TheBitBiscuit/MegaAMP/Mk. I/MegaAMP-Installed.jpeg

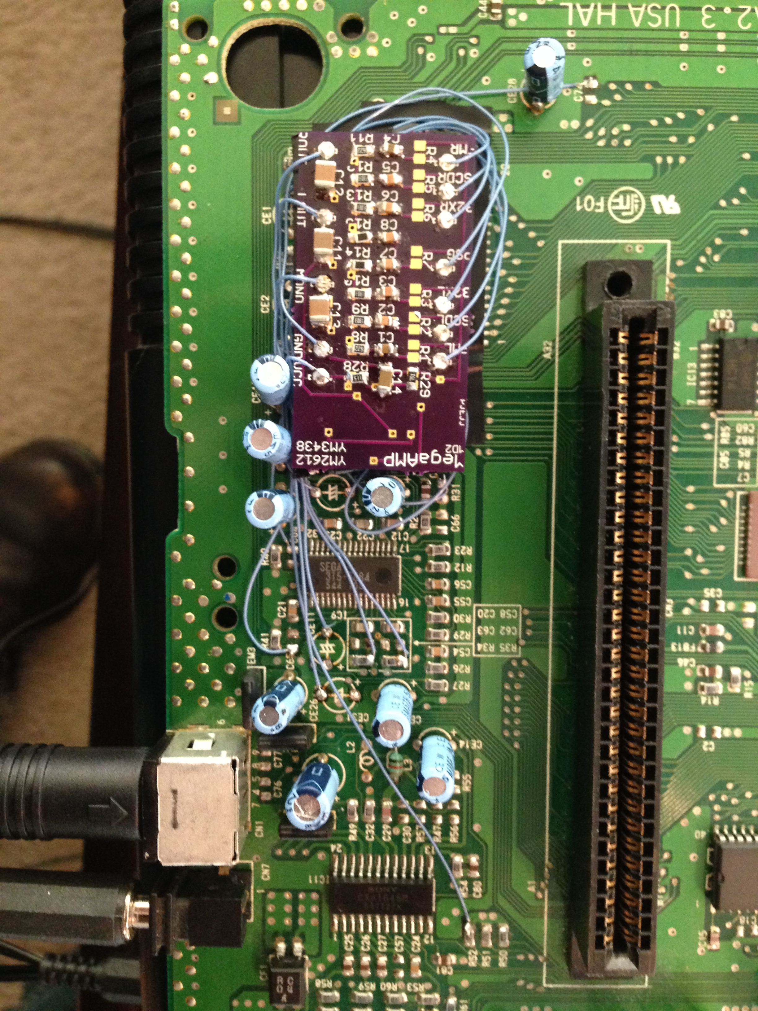
Mk. I/MegaAMP-Installed.jpeg
