TheBitBiscuit/MegaAMP/Install Diagram/MD2VA0-VA1.8-Common.jpg

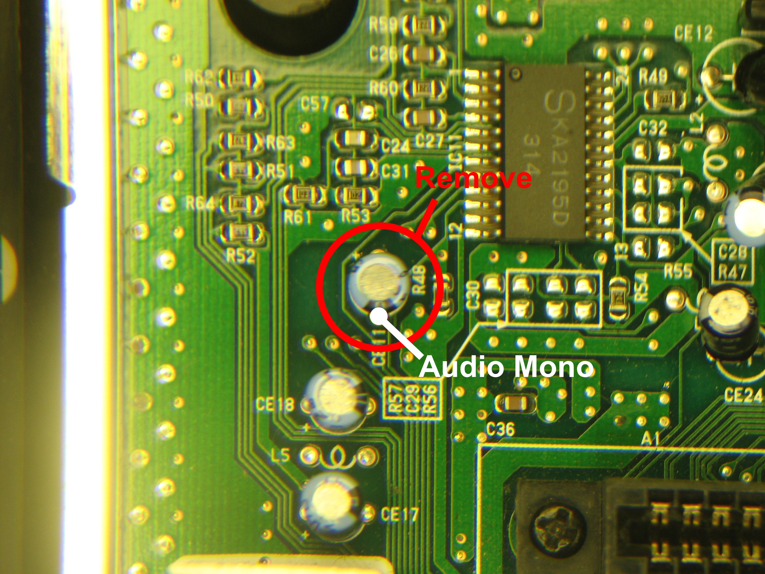
Install Diagram/MD2VA0-VA1.8-Common.jpg
