TheBitBiscuit/MegaAMP/README.md

# MegaAMP
 Audio filter and amplifier for Sega Genesis/Mega Drive.  Board and Schematics were put together with CadSoft Eagle. Mk.I was built and fabbed by OSHpark and installed in one of my own Genesis.
