TheBitBiscuit/MegaAMP/Schmatics/MegaAMP-MD2.png

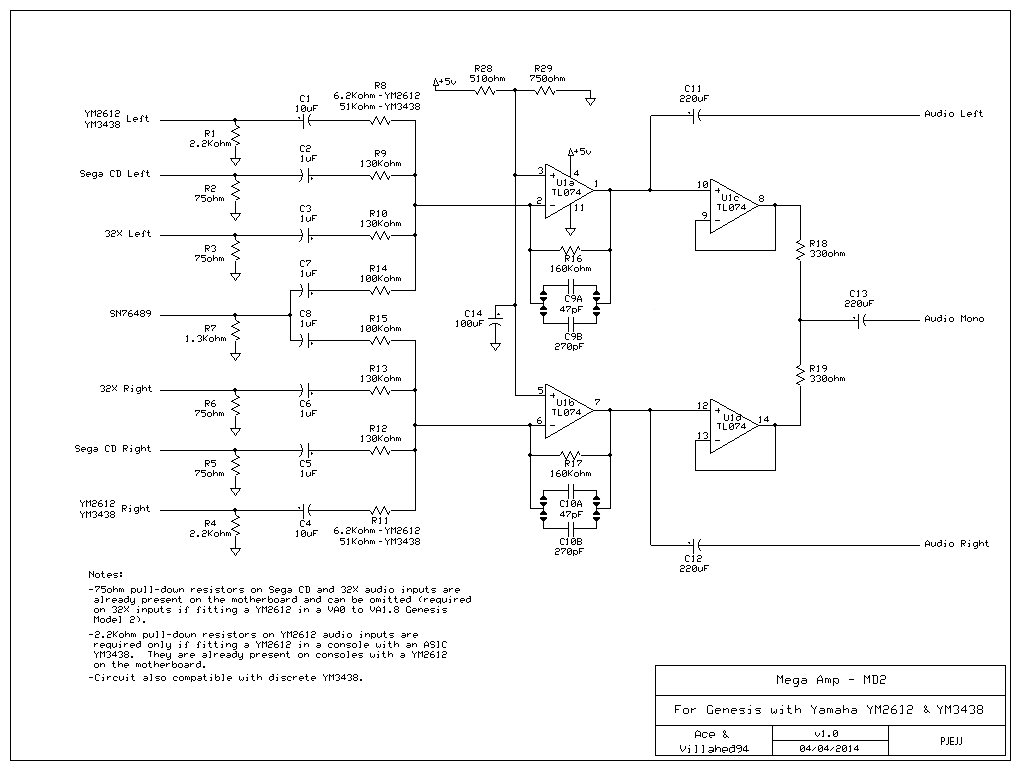
Schmatics/MegaAMP-MD2.png
