TheBitBiscuit/MegaAMP/Mk. I/MegaAMP.Mk1.Parts-List.xlsx

MegaAMP Mk. I Parts List
Name | Value | Package | Digikey Part # | Notes
R1 - Note 1 | 2.2K | 0805 | 311-2.20KCRCT-ND | Note 1
R2 - Note 2 | 75 | 0805 | 311-75.0CRCT-ND | 2.2Kohm pull-down resistors
R3 - Note 2 | 75 | 0805 | 311-75.0CRCT-ND | are only required if fitting a
R4 - Note 1 | 2.2K | 0805 | 311-2.20KCRCT-ND | YM2612 into system with
R5 - Note 2 | 75 | 0805 | 311-75.0CRCT-ND | ASIC YM3438. Already on
R6 - Note 2 | 75 | 0805 | 311-75.0CRCT-ND | the board of YM2612.
R7 | 1.3K | 0805 | 311-1.30KCRCT-ND
R8 - Note 3 | 6.2K - YM2612 | 0805 | 311-6.20KCRCT-ND | Note 2
 | 51K - YM3438 | 0805 | 311-51.0KCRCT-ND | 75ohm pull-down resistors
R9 | 130K | 0805 | 311-130KCRCT-ND | on CD & 32X audio inputs are
R10 | 130K | 0805 | 311-130KCRCT-ND | already present on the board
R11 - Note 3 | 6.2K - YM2612 | 0805 | 311-6.20KCRCT-ND | and can be omitted.
 | 51K - YM3438 | 0805 | 311-51.0KCRCT-ND | (Required on 32X inputs if
R12 | 130K | 0805 | 311-130KCRCT-ND | fitting YM2612 in a VA0 to
R13 | 130K | 0805 | 311-130KCRCT-ND | VA1.8 Model 2)
R14 | 100K | 0805 | 311-100KCRCT-ND
R15 | 100K | 0805 | 311-100KCRCT-ND | Note 3
R16 | 160K | 0805 | 311-160KCRCT-ND | This resistor's value changes
R17 | 160K | 0805 | 311-160KCRCT-ND | depending on what audio
R18 | 330 | 0805 | 311-330CRCT-ND | processor is being used.
R19 | 330 | 0805 | 311-330CRCT-ND | On a YM2612 system, use
R28 | 510 | 0805 | 311-510CRCT-ND | 6.2Kohm.
R29 | 750 | 0805 | 311-750CRCT-ND | On a YM3438 system, use
C1 | 10uF | 0805 | 1276-2891-1-ND | 51Kohm.
C2 | 1uF | 0805 | 1276-1066-1-ND
C3 | 1uF | 0805 | 1276-1066-1-ND
C4 | 10uF | 0805 | 1276-2891-1-ND
C5 | 1uF | 0805 | 1276-1066-1-ND
C6 | 1uF | 0805 | 1276-1066-1-ND
C7 | 1uF | 0805 | 1276-1066-1-ND
C8 | 1uF | 0805 | 1276-1066-1-ND
C9A | 0.47pF | 0805 | 1276-2700-1-ND
C9B | 270pF | 0805 | 1276-1262-1-ND
C10A | 0.47pF | 0805 | 1276-2700-1-ND
C10B | 270pF | 0805 | 1276-1262-1-ND
C11 | 220uF | 1210 | 1276-3375-1-ND
C12 | 220uF | 1210 | 1276-3375-1-ND
C13 | 220uF | 1210 | 1276-3375-1-ND
C14 | 100uF | 1206 | 1276-1782-1-ND
TL074CDR | OPAMP | 14SOIC | 296-1283-1-ND
 |  |  |  | PJEJJ 2014
