TheBitBiscuit/MegaAMP/Mk. I/MegaAMP.Mk1.brd

## EAGLE design Mk. I/MegaAMP.Mk1.brd (2023-05-29)

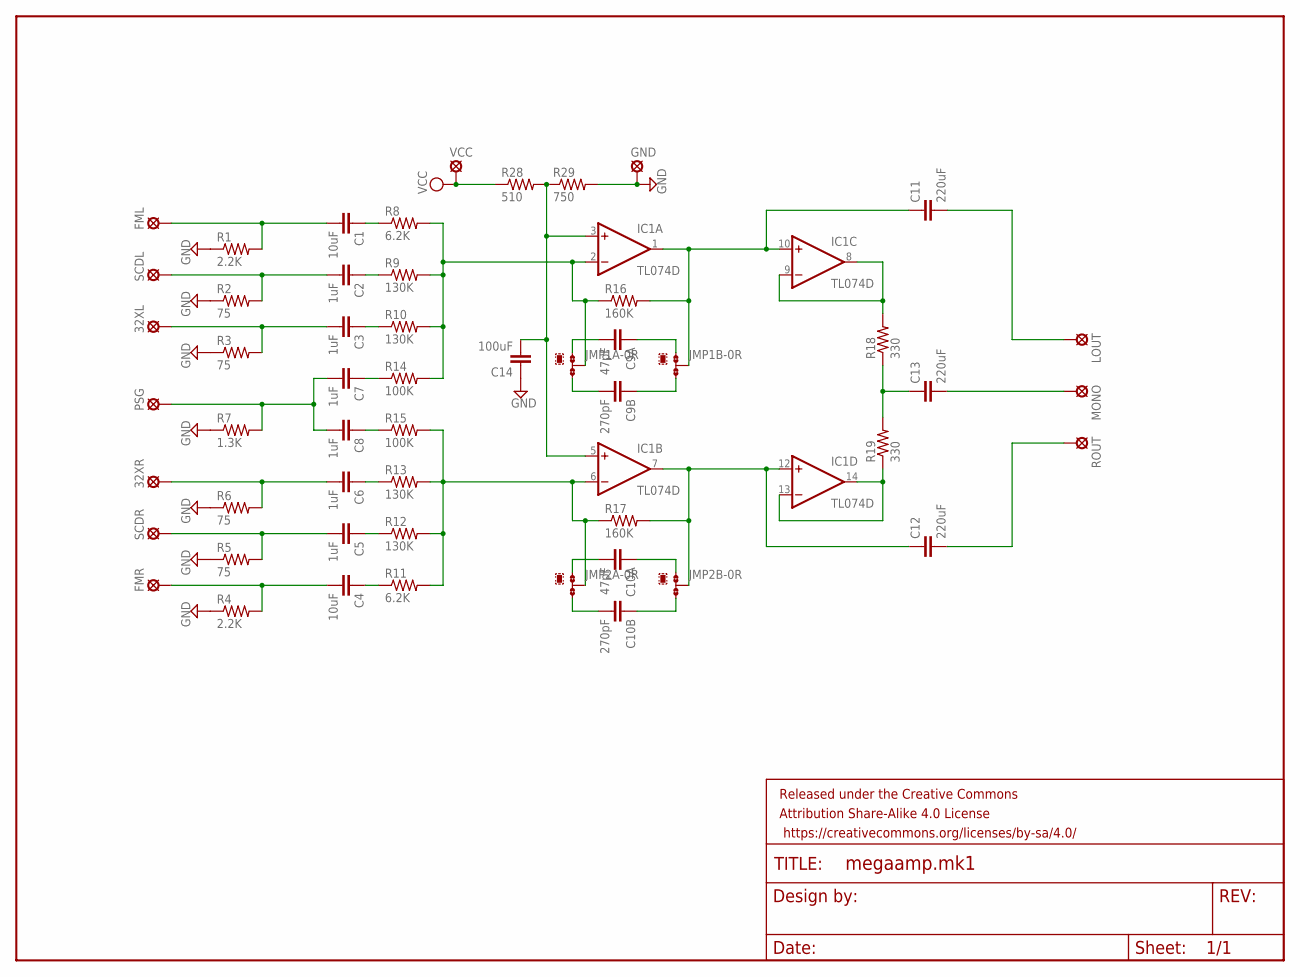
[picture p4: schematic MegaAMP.Mk1.sch]

Parts:
32XL, 32XR: LSP13
C1, C4: 10uF; C0805
C2, C3, C5, C6, C7, C8: 1uF; C0805
C9A, C10A: 47pF; C0805
C9B, C10B: 270pF; C0805
C11, C12, C13: 220uF; C1210
C14: 100uF; C1206
FML: LSP13
FMR: LSP13
FRAME1: FRAME-LETTER; CREATIVE_COMMONS
GND: LSP13
IC1: TL074D; SO14
JMP1A, JMP1B, JMP2A, JMP2B: 0R-JUMPA; A0R-JMP
LOUT: LSP13
MONO: LSP13
PSG: LSP13
R1, R4: 2.2K; R0805
R2, R3, R5, R6: 75; R0805
R7: 1.3K; R0805
R8, R11: 6.2K; R0805
R9, R10, R12, R13: 130K; R0805
R14, R15: 100K; R0805
R16, R17: 160K; R0805
R18, R19: 330; R0805
R28: 510; R0805
R29: 750; R0805
ROUT: LSP13
SCDL: LSP13
SCDR: LSP13
VCC: LSP13

Connections:
GND: C14.1, GND.MP, R1.1, R2.1, R3.1, R4.1, R5.1, R6.1, R7.1, R29.2
unnamed: C11.1, IC1.1 (OUT), IC1.10 (+IN), JMP1B.2, R16.2
unnamed: C13.1, R18.1, R19.2
unnamed: R28.1, VCC.MP
unnamed: C12.2, ROUT.MP
unnamed: C14.2, IC1.3 (+IN), IC1.5 (+IN), R28.2, R29.1
unnamed: IC1.8 (OUT), IC1.9 (-IN), R18.2
unnamed: C9A.2, JMP1A.1
unnamed: IC1.13 (-IN), IC1.14 (OUT), R19.1
unnamed: C9A.1, JMP1B.1
unnamed: C9B.2, JMP1A.3
unnamed: C9B.1, JMP1B.3
unnamed: C12.1, IC1.7 (OUT), IC1.12 (+IN), JMP2B.2, R17.2
unnamed: C10A.2, JMP2A.1
unnamed: C10A.1, JMP2B.1
unnamed: C10B.2, JMP2A.3
unnamed: C10B.1, JMP2B.3
unnamed: C11.2, LOUT.MP
unnamed: C13.2, MONO.MP
unnamed: C1.2, FML.MP, R1.2
unnamed: C2.2, R2.2, SCDL.MP
unnamed: 32XL.MP, C3.2, R3.2
unnamed: C7.2, C8.2, PSG.MP, R7.2
unnamed: 32XR.MP, C6.2, R6.2
unnamed: C5.2, R5.2, SCDR.MP
unnamed: C4.2, FMR.MP, R4.2
unnamed: C1.1, R8.1
unnamed: C2.1, R9.1
unnamed: C3.1, R10.1
unnamed: C7.1, R14.1
unnamed: C8.1, R15.1
unnamed: C6.1, R13.1
unnamed: C5.1, R12.1
unnamed: C4.1, R11.1
unnamed: IC1.2 (-IN), JMP1A.2, R8.2, R9.2, R10.2, R14.2, R16.1
unnamed: IC1.6 (-IN), JMP2A.2, R11.2, R12.2, R13.2, R15.2, R17.1
V+: IC1.4 (V+)
V-: IC1.11 (V-)

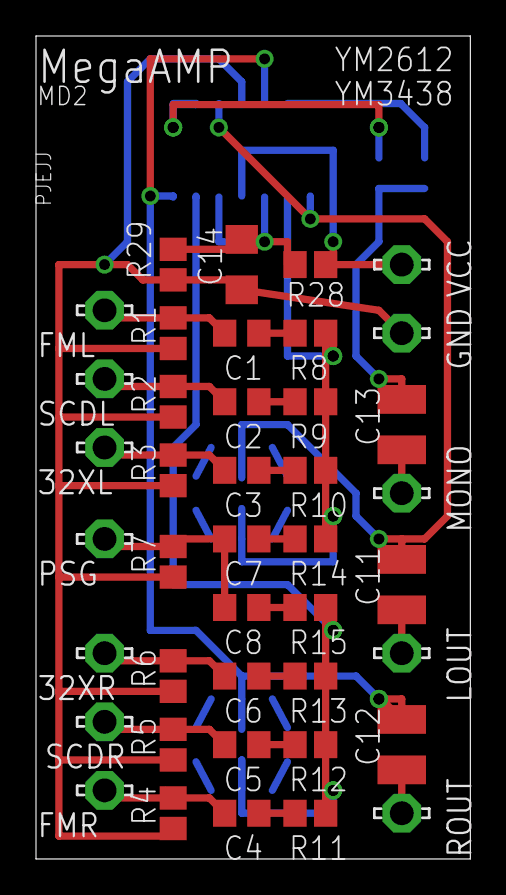
[picture p5: board MegaAMP.Mk1.brd from above]

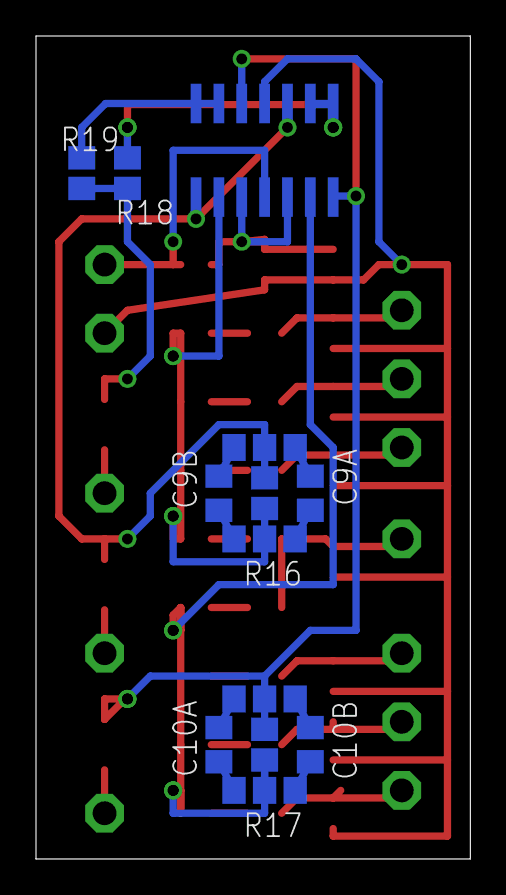
[picture p6: board MegaAMP.Mk1.brd from below]

Board: 2 copper layers, 24.1 x 45.7 mm, 55 parts (13 on the bottom side), 36 nets.
