TheBitBiscuit/MegaAMP/Mk. II/MegaAMP.Mk2.brd

## EAGLE design Mk. II/MegaAMP.Mk2.brd (2023-05-29)

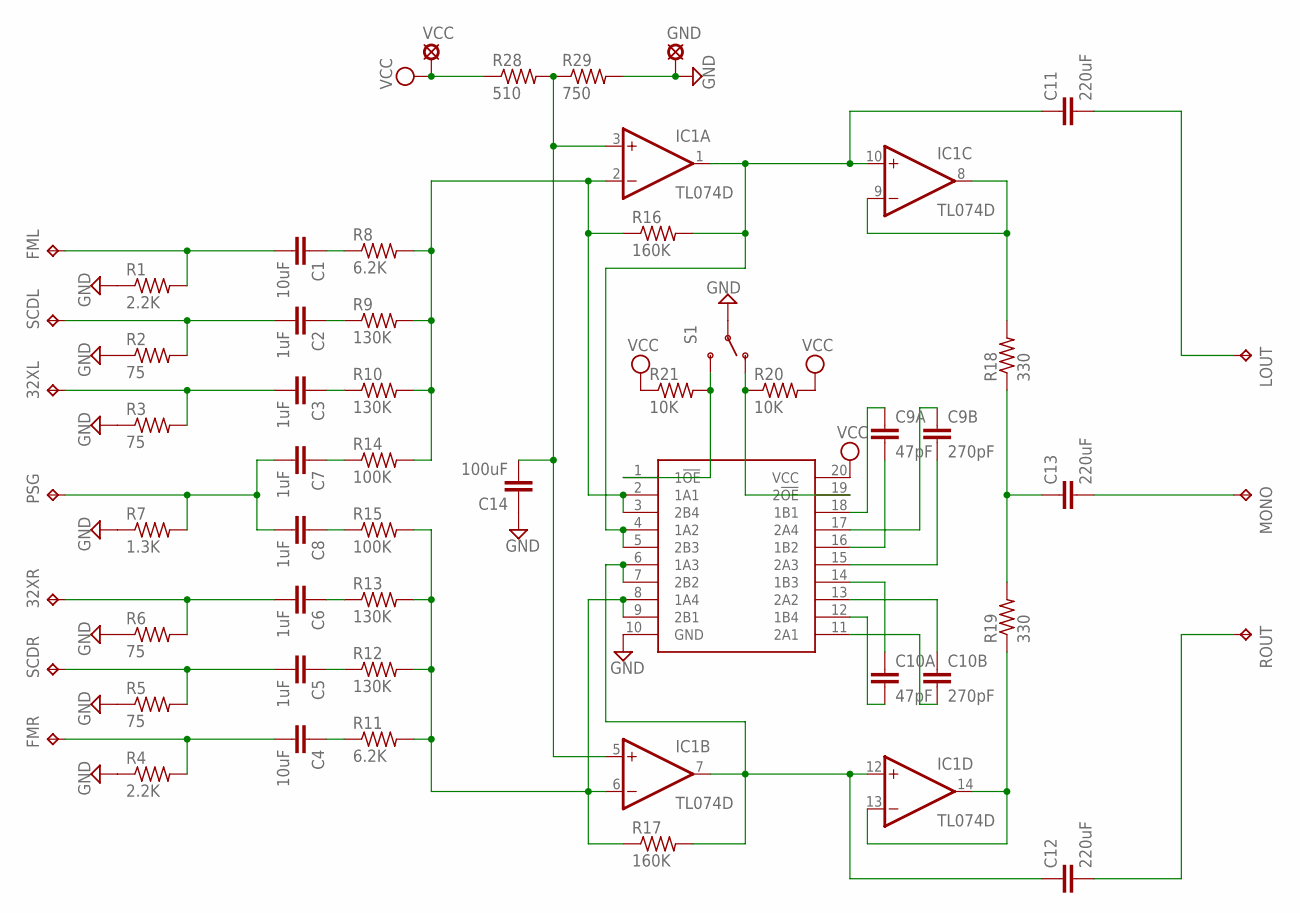
[picture p7: schematic MegaAMP.Mk2.sch]

Parts:
32XL, 32XR: TPTP20R; TP20R
C1, C4: 10uF; C0805
C2, C3, C5, C6, C7, C8: 1uF; C0805
C9A, C10A: 47pF; C0805
C9B, C10B: 270pF; C0805
C11, C12, C13: 220uF; C1210
C14: 100uF; C1206
FML: TPTP20R; TP20R
FMR: TPTP20R; TP20R
GND: LSP13
IC1: TL074D; SO14
LOUT: TPTP20R; TP20R
MONO: TPTP20R; TP20R
PSG: TPTP20R; TP20R
R1, R4: 2.2K; R0805
R2, R3, R5, R6: 75; R0805
R7: 1.3K; R0805
R8, R11: 6.2K; R0805
R9, R10, R12, R13: 130K; R0805
R14, R15: 100K; R0805
R16, R17: 160K; R0805
R18, R19: 330; R0805
R20, R21: 10K; R0805
R28: 510; R0805
R29: 750; R0805
ROUT: TPTP20R; TP20R
S1: SWITCH-SPDTPTH; SWITCH-SPDT
SCDL: TPTP20R; TP20R
SCDR: TPTP20R; TP20R
U$1: DBQ(R-PDS0-G20); DBQ(R-PDSO-G20)
VCC: LSP13

Connections:
GND: C14.1, GND.MP, R1.1, R2.1, R3.1, R4.1, R5.1, R6.1, R7.1, R29.2, S1.2, U$1.10 (GND)
unnamed: IC1.2 (-IN), R8.2, R9.2, R10.2, R14.2, R16.1, U$1.2 (1A1), U$1.3 (2B4)
unnamed: C13.1, R18.1, R19.2
unnamed: R21.2, S1.3 (S), U$1.1 (1!OE)
unnamed: C12.2, ROUT.TP
unnamed: C14.2, IC1.3 (+IN), IC1.5 (+IN), R28.2, R29.1
unnamed: C9A.1, U$1.18 (1B1)
unnamed: IC1.8 (OUT), IC1.9 (-IN), R18.2
unnamed: C9A.2, U$1.16 (1B2)
unnamed: IC1.13 (-IN), IC1.14 (OUT), R19.1
unnamed: C10A.1, U$1.14 (1B3)
unnamed: C10A.2, U$1.12 (1B4)
unnamed: R20.1, S1.1 (O), U$1.19 (2!OE)
unnamed: C12.1, IC1.7 (OUT), IC1.12 (+IN), R17.2, U$1.6 (1A3), U$1.7 (2B2)
unnamed: C9B.1, U$1.17 (2A4)
unnamed: C9B.2, U$1.15 (2A3)
unnamed: C10B.1, U$1.13 (2A2)
unnamed: C10B.2, U$1.11 (2A1)
unnamed: IC1.6 (-IN), R11.2, R12.2, R13.2, R15.2, R17.1, U$1.8 (1A4), U$1.9 (2B1)
unnamed: C11.2, LOUT.TP
unnamed: C13.2, MONO.TP
unnamed: C1.2, FML.TP, R1.2
unnamed: C2.2, R2.2, SCDL.TP
unnamed: 32XL.TP, C3.2, R3.2
unnamed: C7.2, C8.2, PSG.TP, R7.2
unnamed: 32XR.TP, C6.2, R6.2
unnamed: C5.2, R5.2, SCDR.TP
unnamed: C4.2, FMR.TP, R4.2
unnamed: C1.1, R8.1
unnamed: C2.1, R9.1
unnamed: C3.1, R10.1
unnamed: C7.1, R14.1
unnamed: C8.1, R15.1
unnamed: C6.1, R13.1
unnamed: C5.1, R12.1
unnamed: C4.1, R11.1
unnamed: C11.1, IC1.1 (OUT), IC1.10 (+IN), R16.2, U$1.4 (1A2), U$1.5 (2B3)
V+: IC1.4 (V+)
V-: IC1.11 (V-)
VCC: R20.2, R21.1, R28.1, U$1.20 (VCC), VCC.MP

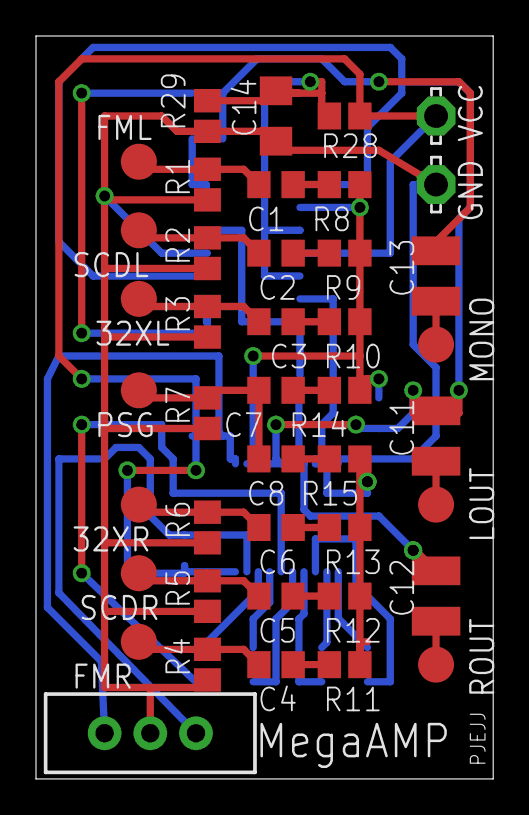
[picture p8: board MegaAMP.Mk2.brd from above]

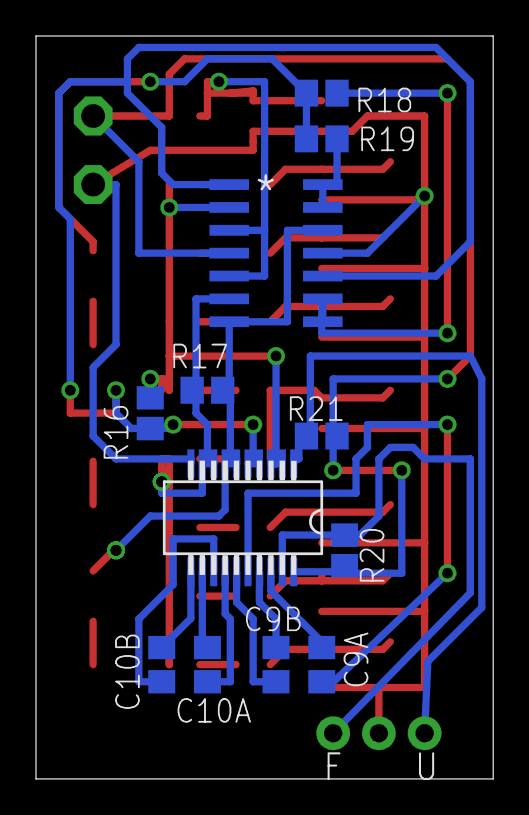
[picture p9: board MegaAMP.Mk2.brd from below]

Board: 2 copper layers, 25.4 x 41.3 mm, 54 parts (12 on the bottom side), 38 nets.
