TheBitBiscuit/MegaAMP/Install Diagram/24i.png

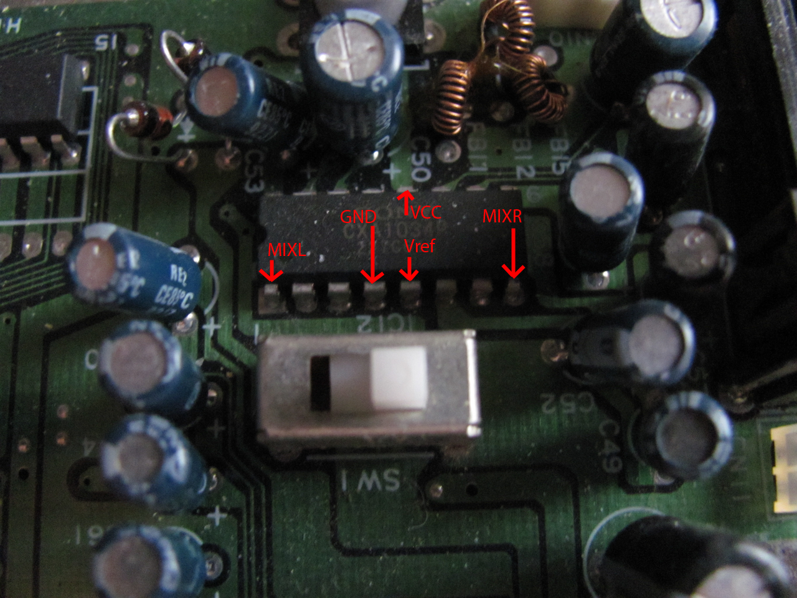
Install Diagram/24i.png
