TheBitBiscuit/MegaAMP/Install Diagram/MD2VA0-Audio.jpg

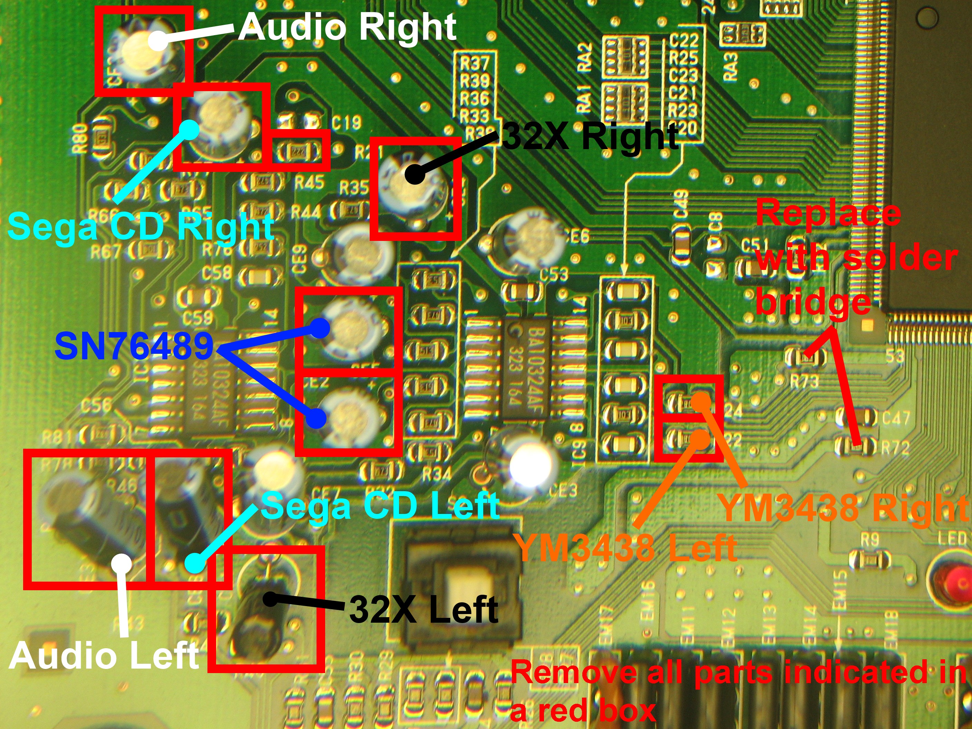
Install Diagram/MD2VA0-Audio.jpg
