TheBitBiscuit/MegaAMP/Install Diagram/MD2VA1-VA1.8-Audio.jpg

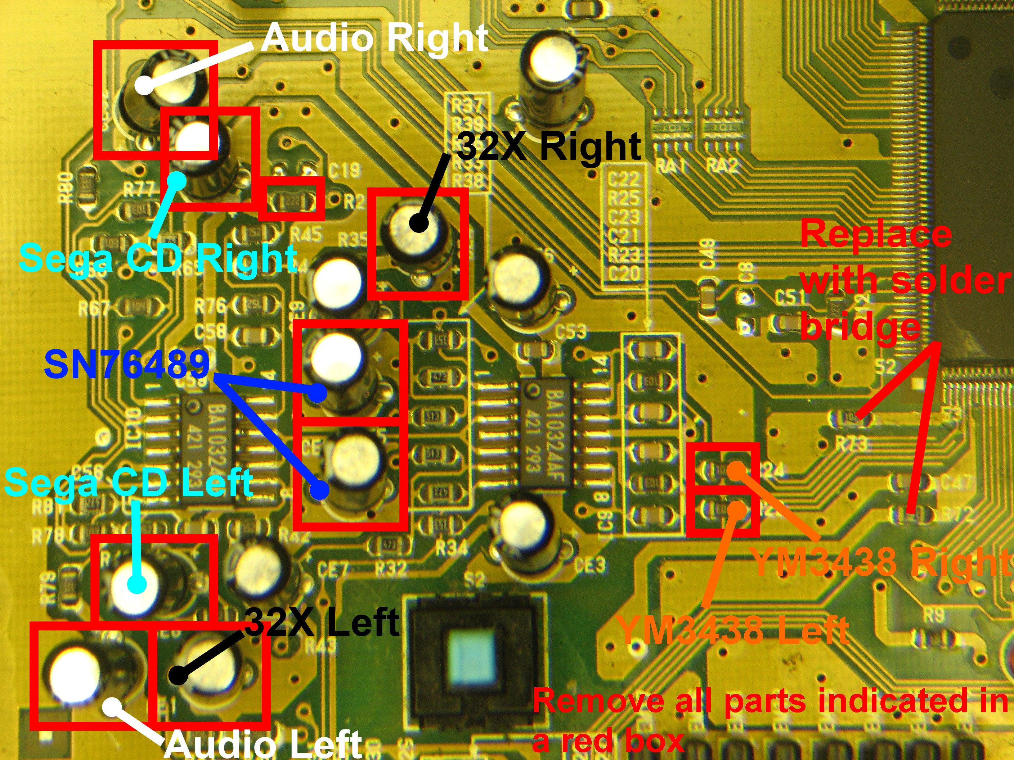
Install Diagram/MD2VA1-VA1.8-Audio.jpg
