TheBitBiscuit/MegaAMP/Install Diagram/MD2VA2-Audio.jpg

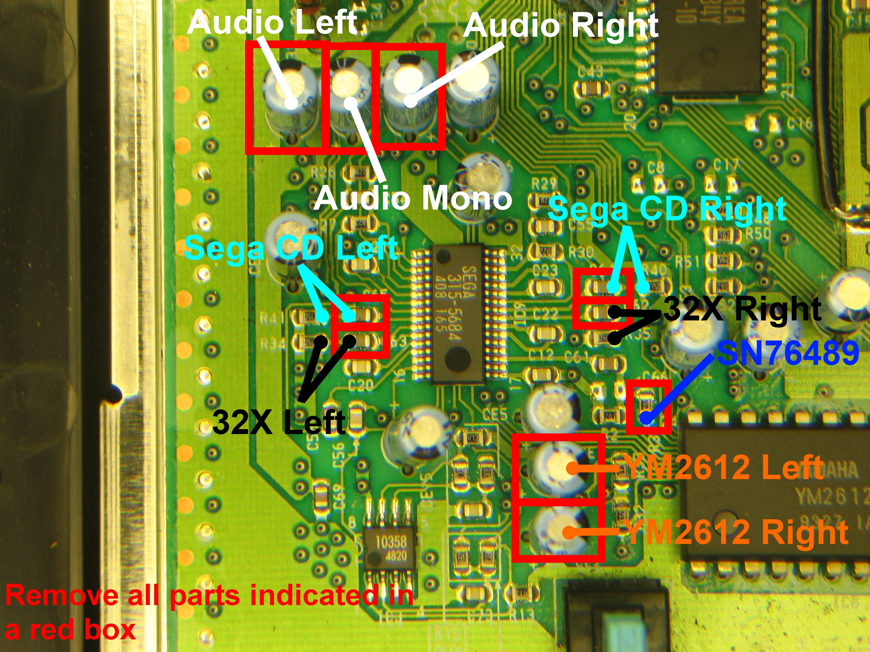
Install Diagram/MD2VA2-Audio.jpg
