TheBitBiscuit/MegaAMP/Install Diagram/MD2VA2.3-Audio.jpg

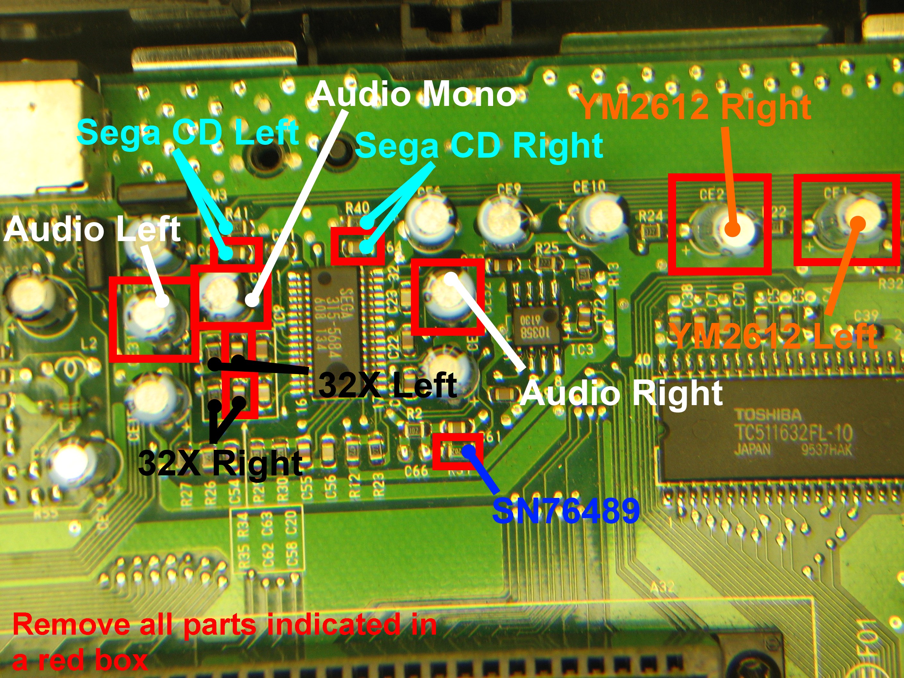
Install Diagram/MD2VA2.3-Audio.jpg
