TheBitBiscuit/MegaAMP/Install Diagram/MD2VA3-Audio.jpg

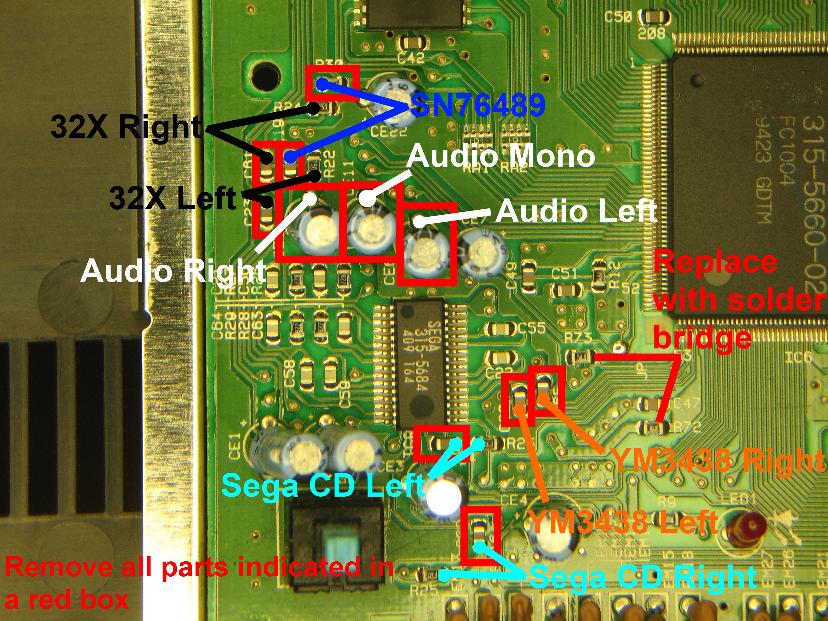
Install Diagram/MD2VA3-Audio.jpg
